Ds-Maker-College/DMC_Tracer_-01/README.md

# DMC Tracer 01 Nano

This is an open-source robot for the DMC Remote Robot contest.
