Ds-Maker-College/DMC_Tracer_-01/Courses/DMC_RoboCon1_Complex_Course.pdf

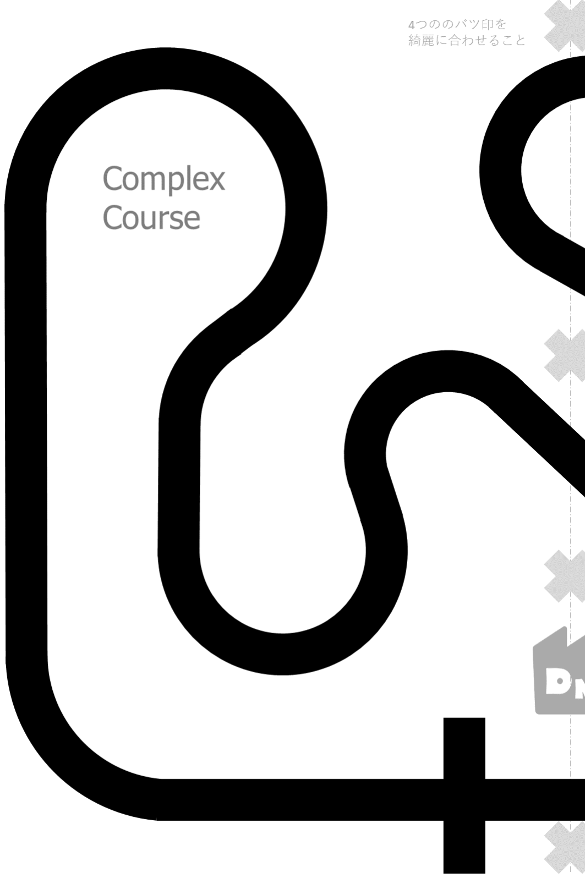
[picture p10: page 1]
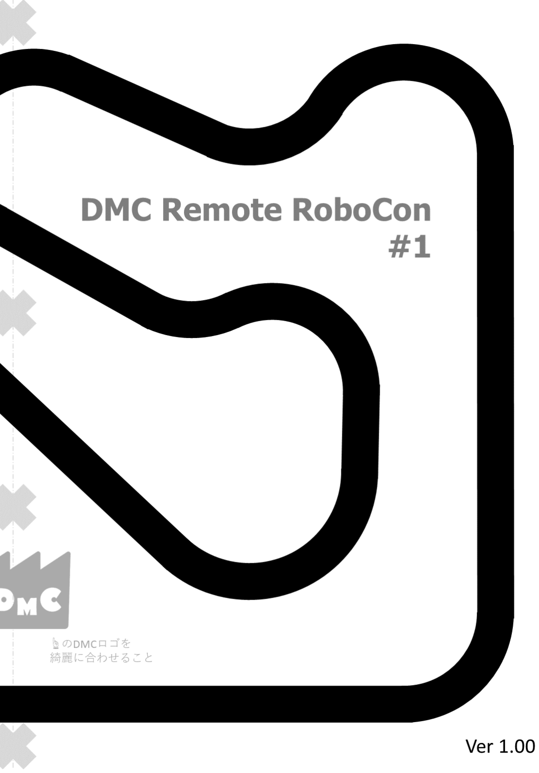
[picture p11: page 2]
