Ds-Maker-College/DMC_Tracer_-01/Courses/DMC_RoboCon1_Simple_Course.pdf

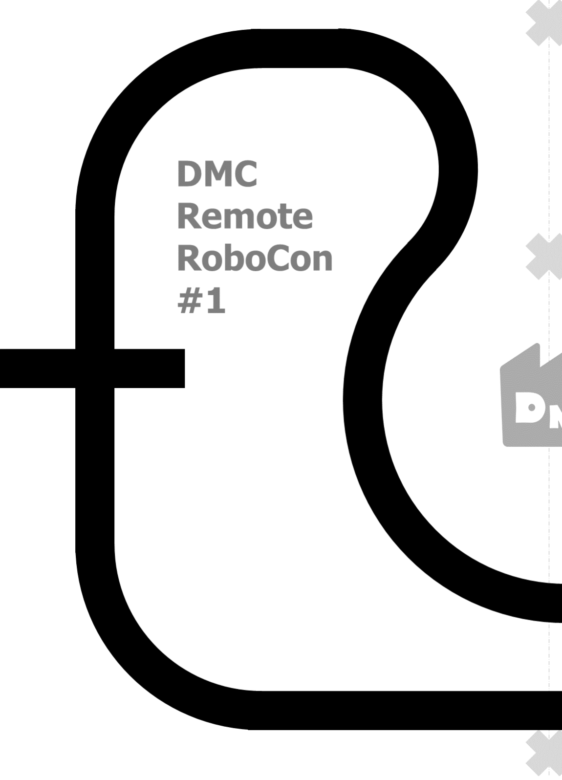
[picture p12: page 1]
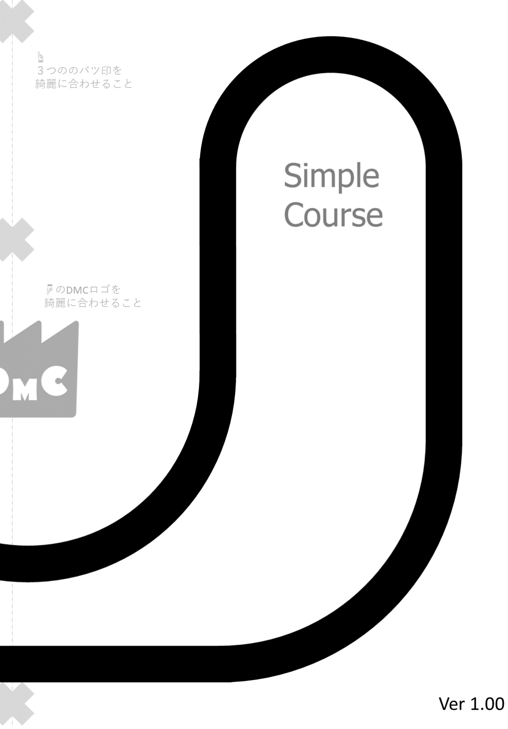
[picture p13: page 2]
