Ds-Maker-College/DMC_Tracer_-01/DMC Tracer Data/V1.1/Parts List.xlsx

部品名 | 製品名（型番) | 数量 | 単価 | 費用 | 調達先 | URL
マイコンボード | Arduino nano互換 | 1 |  |  | アマゾン | https://www.amazon.co.jp/ELEGOO-Arduino-Nano%E3%83%9C%E3%83%BC%E3%83%89-ATmega328P%E3%80%81Arduino-V3-0%E4%BA%92%E6%8F%9B/dp/B072F5NS4X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
I2Cモニタ | OLED 128 × 32 | 1 |  |  | アマゾン | https://www.amazon.co.jp/KKHMF-%E3%82%B7%E3%83%AA%E3%82%A2%E3%83%ABOLED%E6%B6%B2%E6%99%B6%E3%83%87%E3%82%A3%E3%82%B9%E3%83%97%E3%83%AC%E3%82%A4%E3%83%A2%E3%82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
ギヤモーター | FM90 | 2 | 300 | 600 | 秋月 | https://akizukidenshi.com/catalog/g/gM-14801/
ホイール・タイヤ | FS90R-W | 2 | 220 | 440 | 秋月 | http://akizukidenshi.com/catalog/g/gP-13207/
9V電池 |  | 1 | 170 | 170 | 秋月 | https://akizukidenshi.com/catalog/g/gB-03257/
9Vバッテリスナップ |  | 1 | 80 | 80 | 秋月 | https://akizukidenshi.com/catalog/g/gP-07356/
本体基板 | DMC_TracerV1.1 | 1 |  |  | FusionPCB | https://www.fusionpcb.jp/fusion_pcb.html
M2x18ネジ |  | 4 |  |  | 汎用品でOK
M2x8ネジ |  | 6 |  |  | 汎用品でOK
M2x8六角ボルト |  | 6 |  |  | 汎用品でOK
M2ナット |  | 6 |  |  | 汎用品でOK
モーターマウント部品（左右） |  | 2 |  |  | 3Dプリント
リヤスキッド部品 |  | 1 |  |  | 3Dプリント
両面テープ(20cm) |  | 1 |  |  | アマゾン | https://www.amazon.co.jp/OTOKU-%E4%B8%A1%E9%9D%A2%E3%83%86%E3%83%BC%E3%83%97-%E9%AD%94%E6%B3%95%E3%83%86%E3%83%BC%E3%83%97-%E3%81%AE%E3%82%8A%E6%AE%8B%E3%82%8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
