Ds-Maker-College/DMC_Tracer_-01/DMC Tracer Data/V1.1/Parts List(PCB).xlsx

Designator | MPN/Seeed SKU | Qty | Link
CN1,CN2 | 220S-1*15P H=8.5MM Y型 镀金 | 2
J1 | 320120003 | 1
J2,J3 | A2541WR-2P | 2
J4 | 320030017 | 1
R1,R2,R3,R4 | 301010311 | 4
R5,R6 | 301012207 | 2
R7,R8 | 3362P-1-103 | 2
C1,C2 | SVZ1EM101E06E00RAXXX | 2
C3,C4 | 302010138 | 2
L1,L2 | SWPA8040S471MT | 2
D1,D2 | 304060001 | 2
D3 | 304020034 | 1
SW1 | 311030008 | 1
SW2,SW3 | K2-1102DP-K4SW-04 | 2
U1,U2,U3,U4 | ITR9909 | 4
U5 | DRV8835DSSR | 1
