Ds-Maker-College/DMC_Tracer_-01/Mechanical Parts Data/Left_Motor_Mount.SLDPRT

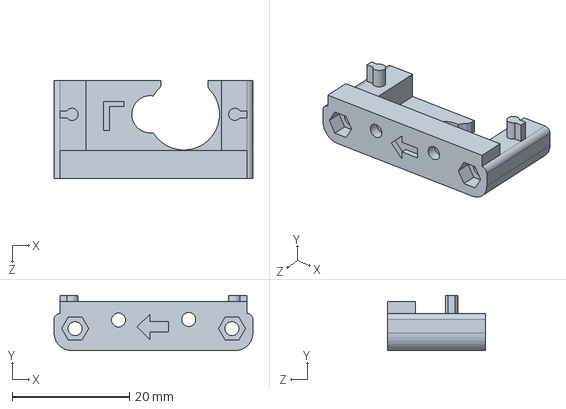
[picture p14: CAD file, 2023-05-11]
Mechanical Parts Data/Left_Motor_Mount.SLDPRT
34.0 x 9.42 x 16.8 mm
