Ds-Maker-College/DMC_Tracer_-01/Mechanical Parts Data/Parts_Set.STL

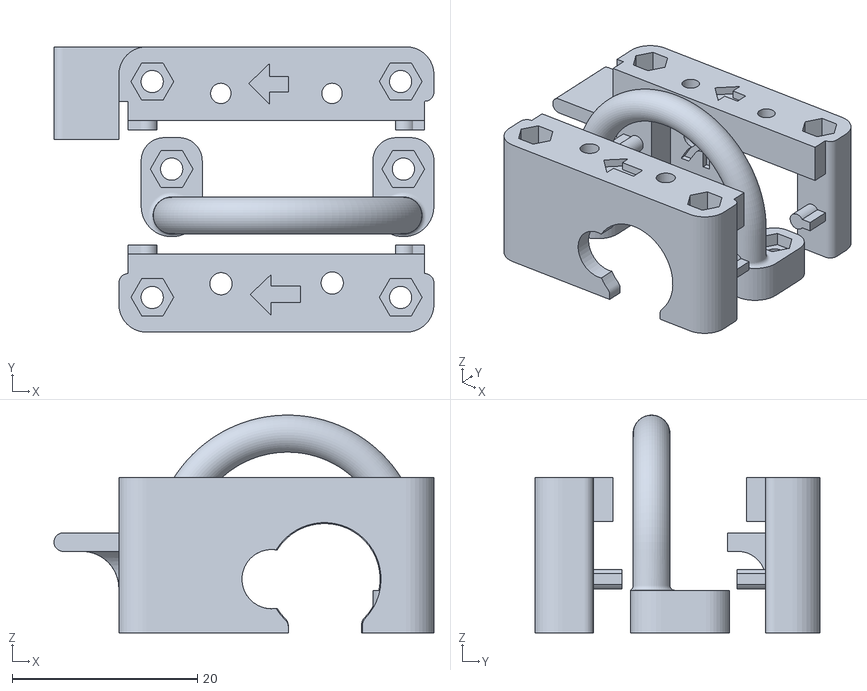
[picture p15: CAD file, 2023-05-11]
Mechanical Parts Data/Parts_Set.STL
41.0 x 30.8 x 23.5
