Ds-Maker-College/DMC_Tracer_-01/Mechanical Parts Data/Right_Motor_Mount.SLDPRT

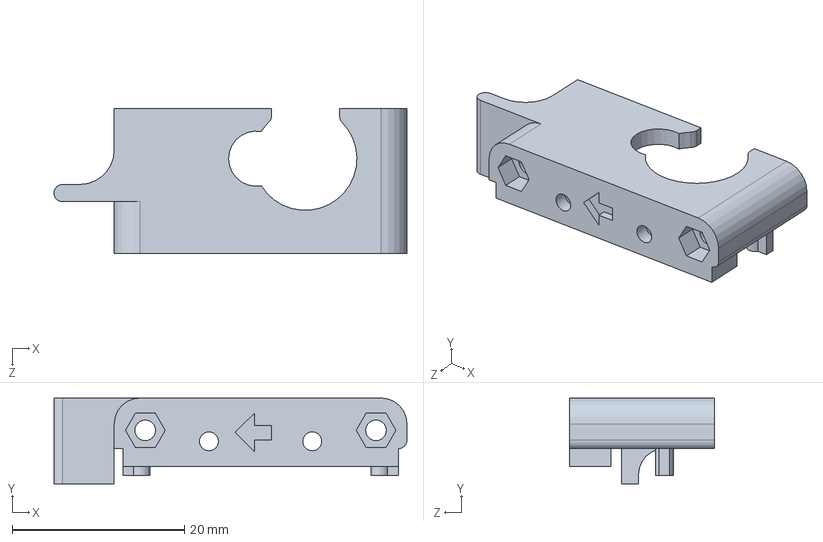
[picture p16: CAD file, 2023-05-11]
Mechanical Parts Data/Right_Motor_Mount.SLDPRT
41.0 x 9.98 x 16.8 mm
