Ds-Maker-College/DMC_Tracer_-01/Mechanical Parts Data/Rear_Skid.SLDPRT

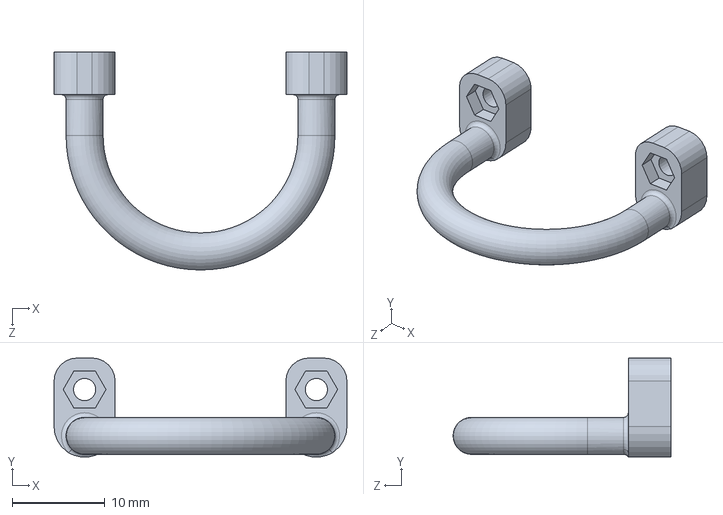
[picture p17: CAD file, 2023-05-11]
Mechanical Parts Data/Rear_Skid.SLDPRT
31.6 x 10.7 x 23.5 mm
