Ds-Maker-College/DMC_Tracer_-01/Courses/Test_Course.pdf

DMC Remote RoboCon

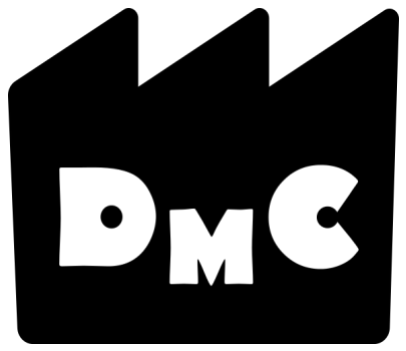
[picture p60: figure]

Test Course
