Ds-Maker-College/DMC_Tracer_-01/DMC Tracer Data/V1.1/DMC_Tracer Schematic.pdf

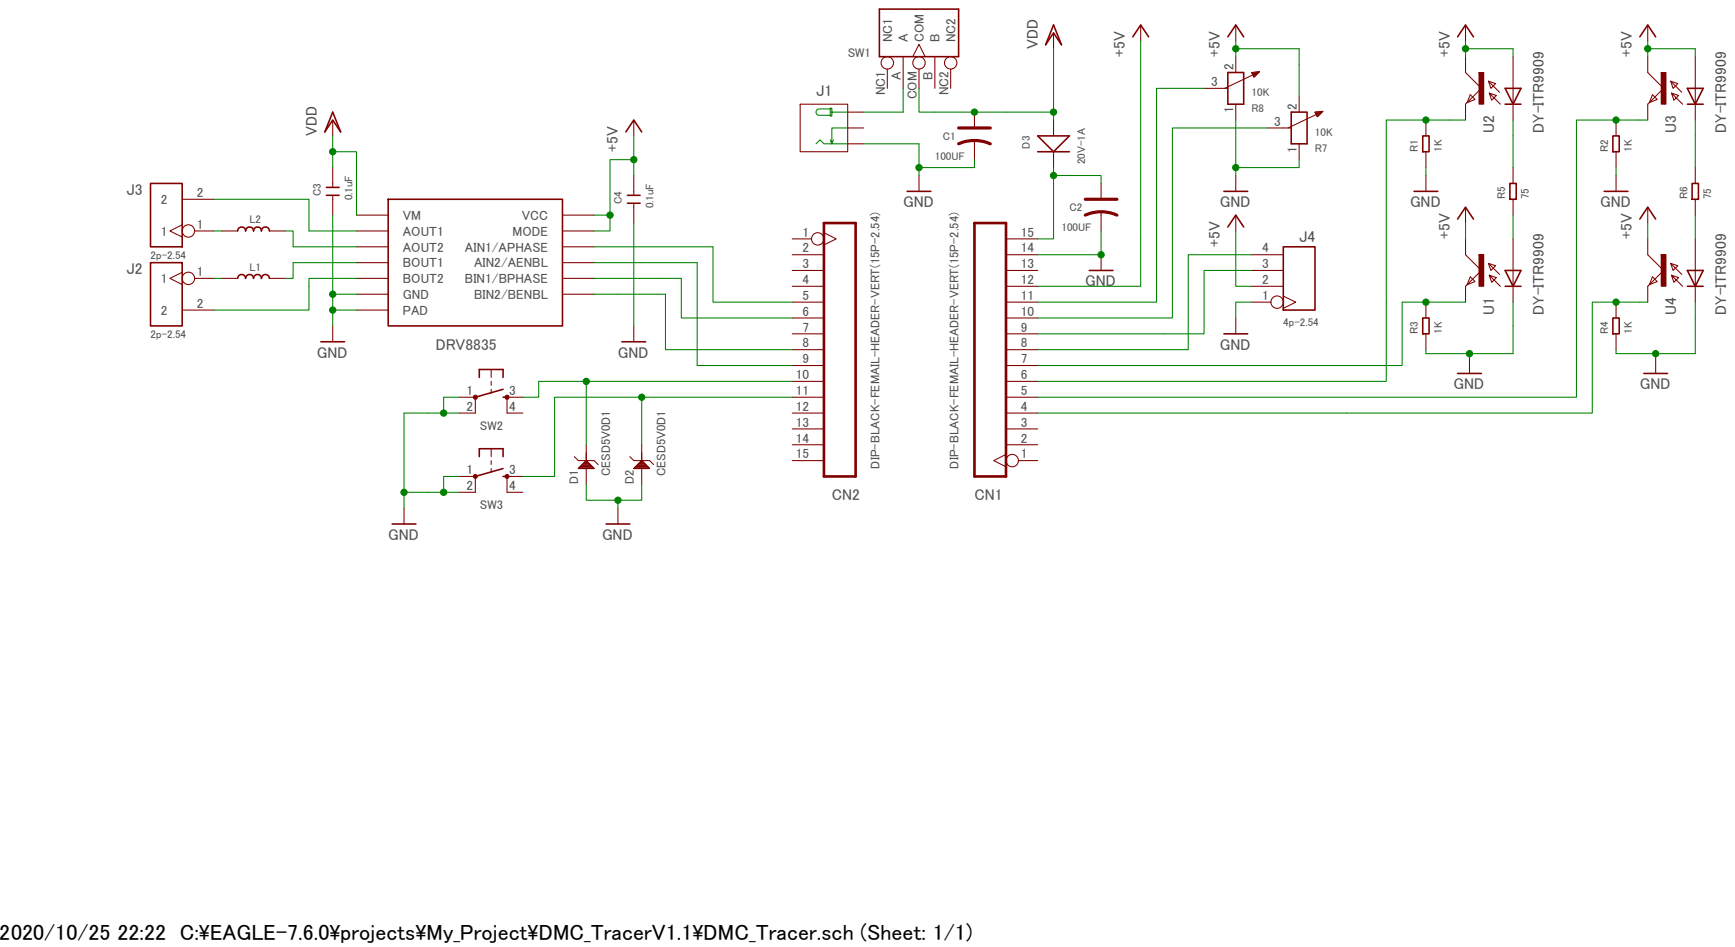
[picture p61: page 1]

DIP-BLACK-FEMAIL-HEADER-VERT(15P-2.54)

2020/10/25 22:22 C:\EAGLE-7.6.0\projects\My_Project\DMC_TracerV1.1\DMC_Tracer.sch (Sheet: 1/1)
