Ds-Maker-College/DMC_Tracer_-01/DMC Tracer Data/V1.1/PP and Mount data V1.1/DMC_TracerV1.1BTM.pdf

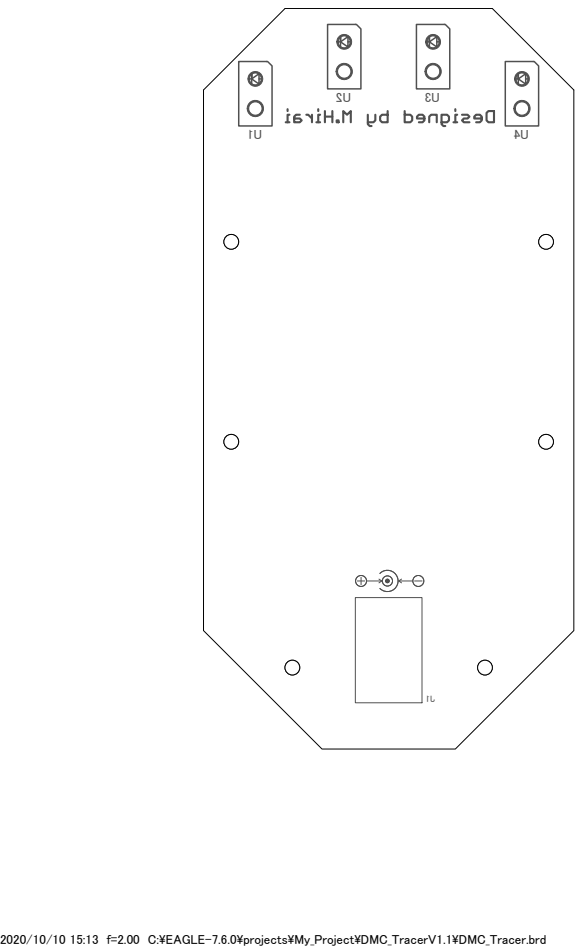
[picture p62: page 1]

2020/10/10 15:13 f=2.00 C:\EAGLE-7.6.0\projects\My_Project\DMC_TracerV1.1\DMC_Tracer.brd
