Ds-Maker-College/DMC_Tracer_-01/DMC Tracer Data/V1.1/PP and Mount data V1.1/DMC_TracerV1.1TOP.pdf

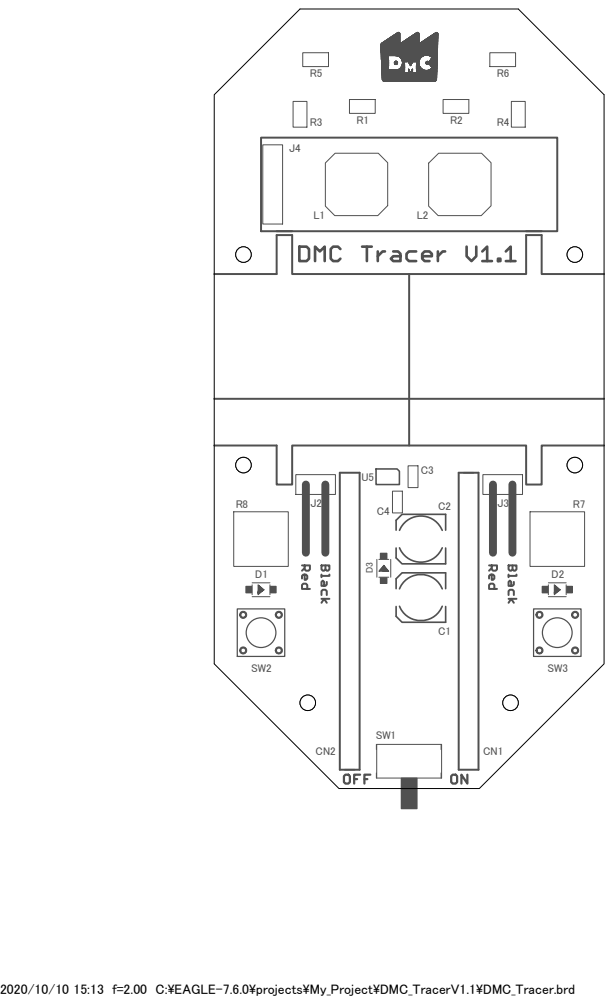
[picture p63: page 1]
