Ds-Maker-College/DMC_Tracer_-01/DMC Tracer Data/V1.1/DMC_TracerV1.1(Eagle data)/DMC_Tracer.brd

## EAGLE design DMC Tracer Data/V1.1/DMC_TracerV1.1(Eagle data)/DMC_Tracer.brd (2023-05-11)

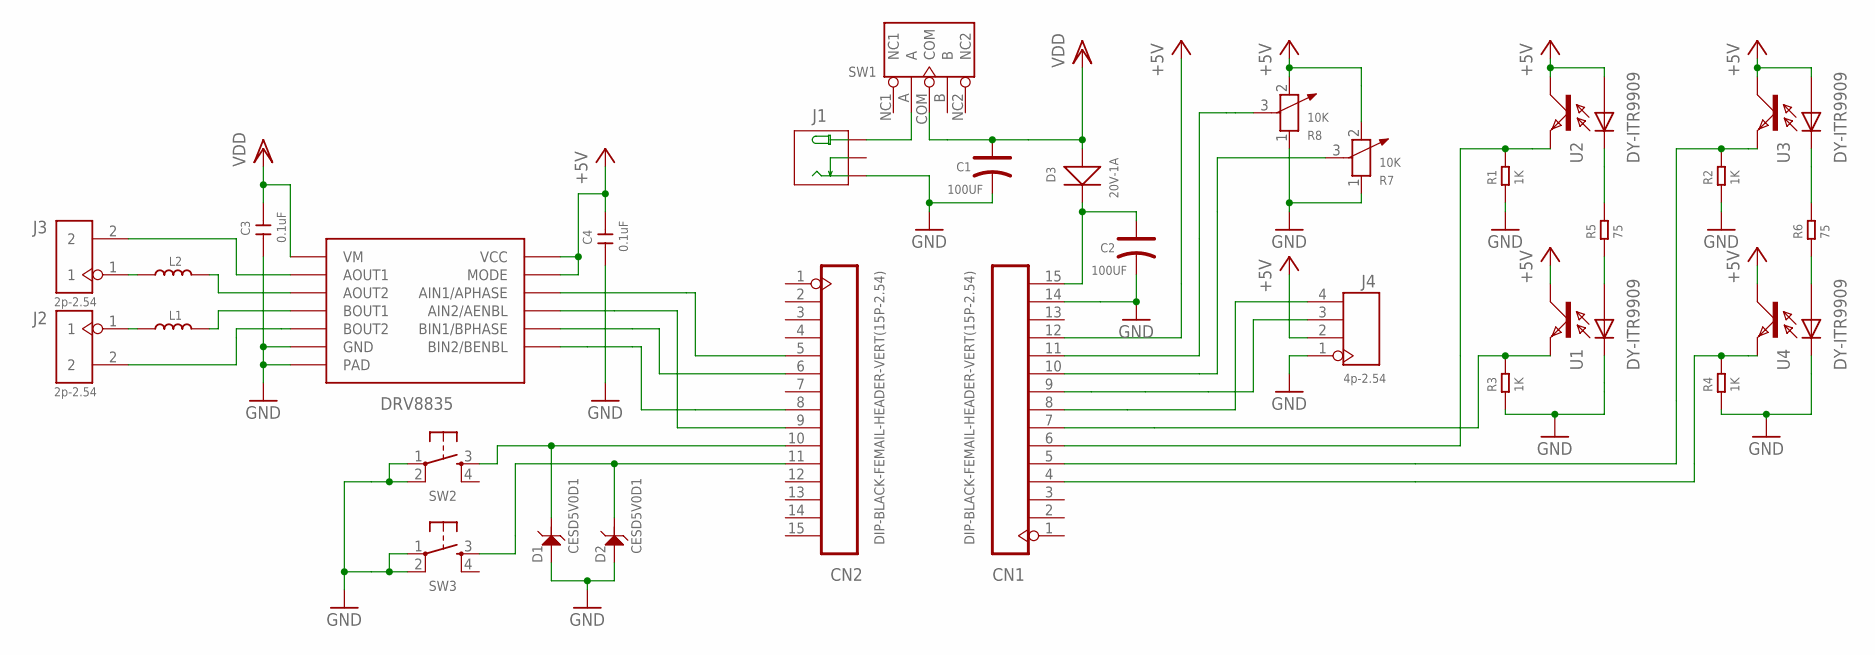
[picture p64: schematic DMC_Tracer.sch]

Parts:
C1, C2: 100UF; ELECTRO-SMD-C-6MM
C3, C4: 0.1uF; C0603
CN1, CN2: DIP-BLACK-FEMAIL-HEADER-VERT(15P-2.54); H15-2.54
D1, D2: CESD5V0D1; SOD-123
D3: 20V-1A; SOD-123
J1: DC-005; 3P-L14.2*W11.0*H9.0MM
J2, J3: 2p-2.54; H2-2.54
J4: 4p-2.54; H4-2.54
L1, L2: SMD-INDUCTOR(2P-8X8MM); L8040
R1, R2, R3, R4: 1K; R0805
R5, R6: 75; R0805
R7, R8: 10K; ADJR3-7.0X7.0X5.0MM
SW1: DIP-TOGGLE-SWITCH-ON-ON(3+2P-8.8X4.6MM)-90D; SW5-2.0-8.8X4.4X4.7MM-90D
SW2, SW3: T-SWITCH-10-SEEED; B3F-10XX-SEEED
U1, U2, U3, U4: DY-ITR9909
U$1: DRV8835; WSON12

Connections:
+5V: C4.1, CN1.12, J4.2, R7.2, R8.2, U1.C, U2.A, U2.C, U3.A, U3.C, U4.C, U$1.P$11 (MODE), U$1.P$12 (VCC)
AOUT1: L2.2, U$1.P$3 (AOUT2)
AOUT2: J3.2, U$1.P$2 (AOUT1)
BOUT1: J2.2, U$1.P$5 (BOUT2)
BOUT2: L1.2, U$1.P$4 (BOUT1)
GND: C1.-, C2.-, C3.2, C4.2, CN1.14, D1.+ (1), D2.+ (1), J1.-1 (-), J4.1, R1.1, R2.1, R3.1, R4.1, R7.1, R8.1, SW2.1, SW2.2 (P1), SW3.1, SW3.2 (P1), U1.K, U4.K, U$1.P$6 (GND), U$1.P$13 (PAD), U$1.P$14 (GND)
unnamed: CN1.8, J4.4
unnamed: CN1.9, J4.3
unnamed: CN2.10, D1.- (2), SW2.3 (S)
unnamed: CN2.11, D2.- (2), SW3.3 (S)
unnamed: CN1.10, R7.3
unnamed: CN1.6, R1.2, U2.E
unnamed: CN1.5, R2.2, U3.E
unnamed: CN1.4, R4.2, U4.E
unnamed: R5.2, U2.K
unnamed: J1.+, SW1.A
unnamed: CN2.5, U$1.P$10 (AIN1/APHASE)
unnamed: R6.2, U3.K
unnamed: J3.1, L2.1
unnamed: R6.1, U4.A
unnamed: R5.1, U1.A
unnamed: CN2.6, U$1.P$8 (BIN1/BPHASE)
unnamed: CN2.9, U$1.P$9 (AIN2/AENBL)
unnamed: CN2.8, U$1.P$7 (BIN2/BENBL)
unnamed: J2.1, L1.1
unnamed: C2.+, CN1.15, D3.-
unnamed: CN1.11, R8.3
unnamed: CN1.7, R3.2, U1.E
VDD: C1.+, C3.1, D3.+, SW1.COM, U$1.P$1 (VM)

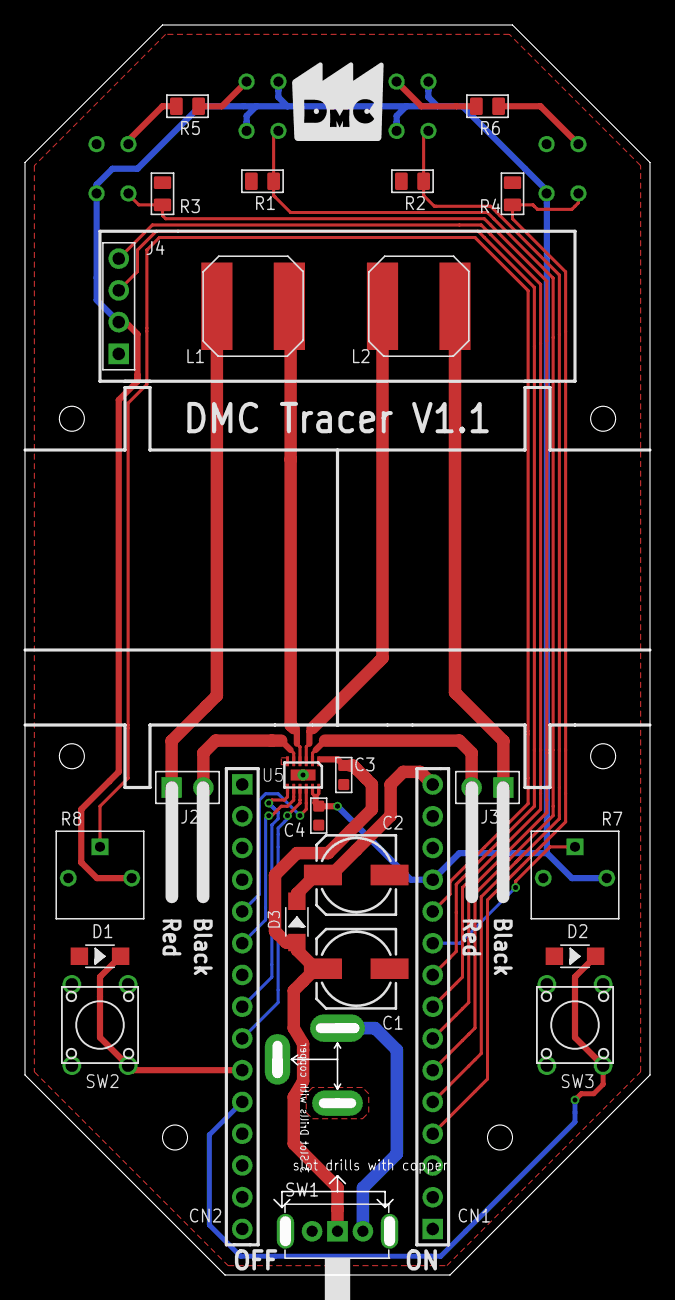
[picture p65: board DMC_Tracer.brd from above]

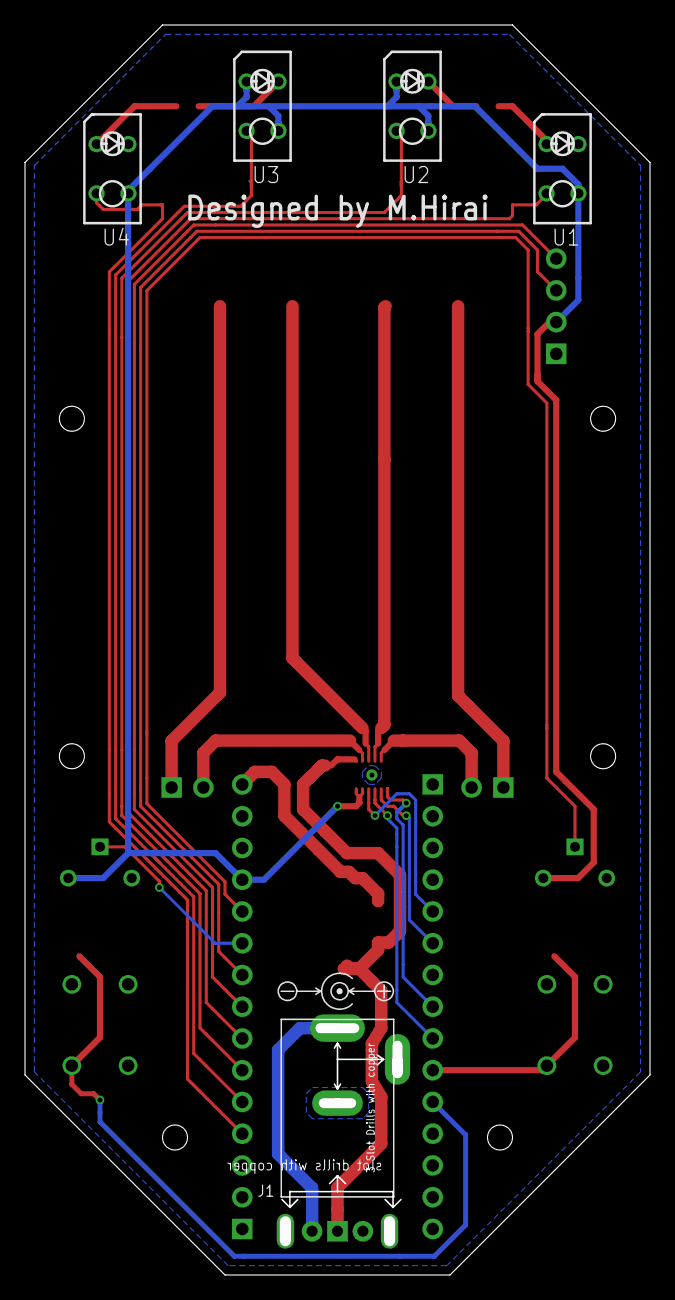
[picture p66: board DMC_Tracer.brd from below]

Board: 2 copper layers, 50.0 x 100.0 mm, 31 parts (5 on the bottom side), 29 nets.
