Ds-Maker-College/DMC_Tracer_-01/Sample Code/Educational Set/06_sample_control/06_sample_control.ino

/////////////////////////////////////////////////////
//    Sample soft for DMC_tracer sample control 
// 
//    Copyright(C) 2021 <DMC>
//    Copyright(C) 2021 M.Hirai, Y.Okada
//    All rights reserved.
// 
//    License: Apache License, Version 2.0
//    https://www.apache.org/licenses/LICENSE-2.0
// 
/////////////////////////////////////////////////////

////////ハードウェアパラメータ/////////
//OLED 関係 基本的に触らない
#include<Wire.h>
#include <Adafruit_SSD1306.h>
#define SCREEN_WIDTH 128 // OLED display width, in pixels
#define SCREEN_HEIGHT 32 // OLED display height, in pixels
// Declaration for an SSD1306 display connected to I2C (SDA, SCL pins)
#define OLED_RESET     4 // Reset pin # (or -1 if sharing Arduino reset pin)
Adafruit_SSD1306 display(SCREEN_WIDTH, SCREEN_HEIGHT, &Wire, OLED_RESET);

// ピン設定
//LED
#define LED       13

//プッシュSW
#define SW_L      7 //スイッチ左
#define SW_R      8 //スイッチ右

//ラインセンサAD
#define LS_L2     3 //外側左センサAD (黒　0->1023　白)
#define LS_L1     2 //内側左センサAD (黒　0->1023　白)
#define LS_R1     1 //内側右センサAD (黒　0->1023　白)
#define LS_R2     0 //外側右センサAD (黒　0->1023　白)

//可変抵抗
#define VR_L      7 //左可変抵抗AD(0->1023)
#define VR_R      6 //右可変抵抗AD(0->1023)

#define MT_PWM_L  5 //左モータPWM (停止 0 -> 255 早)
#define MT_DIR_L  3 //左モータ回転方向 (バック 0 -> 1　前進)
#define MT_PWM_R  6 //右モータPWM (停止 0 -> 255 早)
#define MT_DIR_R  2 //右モータ回転方向 (前進 0 -> 1　バック)

////////ソフトウェアパラメータ/////////

// 定数設定--------------------
#define SW_OFF  HIGH
#define SW_ON   LOW
#define MT_FORWARD_L  HIGH
#define MT_REVERSE_L  LOW
#define MT_FORWARD_R  LOW
#define MT_REVERSE_R  HIGH
//----------------------------

//パラメータ設定-------------------------------------------
#define THREAD_LINE 200 //IRセンサがゴールラインを認識する閾値
#define LAP_NUM 2       //周回数(レースモード時)

#define MOTOR_MAX 255
#define MOTOR_MIN 0

#define LS_L1_MAX 520
#define LS_L1_MIN 60
#define LS_R1_MAX 570
#define LS_R1_MIN 70

#define LS_L2_MAX 390
#define LS_L2_MIN 50
#define LS_R2_MAX 390
#define LS_R2_MIN 50
//-------------------------------------------------------

//変数宣言---------------------
long  line_sensor_l1;
long  line_sensor_r1;
long  line_sensor_l2;
long  line_sensor_r2;

long  vr_ad_l;
long  vr_ad_r;

long  vel_set_l;
long  vel_set_r;

unsigned long start_time;
unsigned long total_time;
unsigned long lap_time[LAP_NUM+1];
unsigned long boot_time;
byte n_lap = 0;

//----------------------------

//初期設定関数
void setup() {
  // put your setup code here, to run once:
  //　起動時最初に１回だけ走るプログラム

  //IOポート設定
  pinMode(LED,OUTPUT);
  pinMode(SW_R,INPUT_PULLUP);
  pinMode(SW_L,INPUT_PULLUP);

  //モータの回転方向を設定
  digitalWrite(MT_DIR_L,MT_FORWARD_L);  //前進
  digitalWrite(MT_DIR_R,MT_FORWARD_R);  //前進
  
  //シリアル通信を開始
  Serial.begin(9600);

  // Wire(Arduino-I2C)の初期化
  Wire.begin();
  
  //OLED初期化　Address 0x3C for 128x32
  if (!display.begin(SSD1306_SWITCHCAPVCC, 0x3C)){ 
    Serial.println(F("SSD1306 allocation failed"));
    while(1); // Don't proceed, loop forever
  }

  //機種名をOLEDに表示----------------
  display.clearDisplay();
  display.setTextSize(2); 
  display.setTextColor(SSD1306_WHITE);
  display.setCursor(4,7);
  display.print(F("DMC TRACER"));
  display.display();
  delay(1000);
 //----------------------------------

  //走行前にセンサの確認
  while(1){

    //右スイッチが推されたらループを出る
    if( digitalRead(SW_R) == SW_ON ){break;}
    
    //ラインセンサを読み込む
    line_sensor_l1 = analogRead(LS_L1);
    line_sensor_r1 = analogRead(LS_R1);
    line_sensor_l2 = analogRead(LS_L2);
    line_sensor_r2 = analogRead(LS_R2);

    //ボリュームの読み込み
    vr_ad_l  = analogRead(VR_L);
    vr_ad_r  = analogRead(VR_R);

    //ボリュームのAD値(10bit)をPWM値(8bit)に変換
    vel_set_l = vr_ad_l * 255 / 1023;
    vel_set_r = vr_ad_r * 255 / 1023;

    //シリアル通信でセンサの値を確認
    Serial.print(line_sensor_l2);   //ラインセンサ左の外側の値を表示
    Serial.print("\t");
    Serial.print(line_sensor_l1);   //ラインセンサ左の内側の値を表示
    Serial.print("\t");
    Serial.print(line_sensor_r1);   //ラインセンサ右の内側の値を表示
    Serial.print("\t");
    Serial.print(line_sensor_r2);   //ラインセンサ右の外側の値を表示
    Serial.print("\t");

    Serial.print(vr_ad_l);          //左ボリュームの値を表示
    Serial.print("\t");
    Serial.print(vr_ad_r);          //右ボリュームの値を表示
    Serial.print("\t");

    Serial.print(vel_set_l);        //左輪速度設定の値を表示
    Serial.print("\t");
    Serial.print(vel_set_r);        //右輪速度設定の値を表示
    Serial.print("\t");
    Serial.println("");   // 改行

    //OLEDに各パラメータ値出力(デバッグ用)
    display.clearDisplay();
    display.setTextSize(1); // Draw 2X-scale text
    display.setTextColor(SSD1306_WHITE);

    //一段目の表示　ソフトのバージョン
    display.setCursor(0, 0);
    display.print(F("Ver:Sample Control"));
    
    //二段目の表示　ボリュームの速度設定
    display.setCursor(0, 11);
    display.print(F("VsetL:"));
    display.print(vel_set_l);
    display.print(", ");
    display.print(F("VsetR:"));
    display.print(vel_set_r);
    display.print("\n");

    //三段目の表示　ラインセンサの値
    display.setCursor(0,22);
    display.println(F("Sens"));
    display.setCursor(35,22);
    display.println(line_sensor_l2, DEC);
    display.setCursor(60,22);
    display.println(line_sensor_l1, DEC);
    display.setCursor(85,22);
    display.println(line_sensor_r1, DEC);
    display.setCursor(110,22);
    display.println(line_sensor_r2, DEC);
    display.display();
    delay(10);
  }
}

//メインループ
void loop() {

  // put your main code here, to run repeatedly:

  long  ls_l1,ls_r1,ls_l2,ls_r2;  //ラインセンサ正規化用変数
  long  line_control;             //ライン制御用差分計算変数

  int   motor_set_L;  //左モーターの速度セット変数
  int   motor_set_R;  //右モーターの速度セット変数
 
  //繰り返し走るプログラム

  //ラインセンサ値を読み込む
  line_sensor_l1 = analogRead(LS_L1);
  line_sensor_r1 = analogRead(LS_R1);
  line_sensor_l2 = analogRead(LS_L2);
  line_sensor_r2 = analogRead(LS_R2);

  //センサ値の正規化処理
  ls_l1 = (line_sensor_l1 - LS_L1_MIN) * 1024 / (LS_L1_MAX - LS_L1_MIN);
  ls_r1 = (line_sensor_r1 - LS_R1_MIN) * 1024 / (LS_R1_MAX - LS_R1_MIN);
  ls_l2 = (line_sensor_l2 - LS_L2_MIN) * 1024 / (LS_L2_MAX - LS_L2_MIN);
  ls_r2 = (line_sensor_r2 - LS_R2_MIN) * 1024 / (LS_R2_MAX - LS_R2_MIN);

  //ラインセンサ値の最小ガード
  if(ls_l1 < 0){ ls_l1 = 0; }
  if(ls_r1 < 0){ ls_r1 = 0; }
  if(ls_l2 < 0){ ls_l2 = 0; }
  if(ls_r2 < 0){ ls_r2 = 0; }

  //ラインセンサ値の最大ガード
  if(ls_l1 >= 1024){ ls_l1 = 1024; }
  if(ls_r1 >= 1024){ ls_r1 = 1024; }
  if(ls_l2 >= 1024){ ls_l2 = 1024; }
  if(ls_r2 >= 1024){ ls_r2 = 1024; }

  line_control = (int)line_sensor_l1 - (int)line_sensor_r1 + 2*((int)line_sensor_l2 - (int)line_sensor_r2);

  motor_set_L = vel_set_l + line_control / 15;
  motor_set_R = vel_set_r - line_control / 15;
  
  //モーター駆動処理
  //左モーター出力
  if(motor_set_L >= 0){
    if(motor_set_L > MOTOR_MAX) {motor_set_L = MOTOR_MAX;}  //モーター制御値上下ガード処理
    if(motor_set_L <= MOTOR_MIN){motor_set_L = MOTOR_MIN;}  //モーター制御値上下ガード処理
    digitalWrite(MT_DIR_L, MT_FORWARD_L);
    analogWrite(MT_PWM_L, motor_set_L);       // 左モーターPWM 
  }
  else if(motor_set_L < 0){
    motor_set_L = -motor_set_L;
    if(motor_set_L > MOTOR_MAX) {motor_set_L = MOTOR_MAX;}  //モーター制御値上下ガード処理
    if(motor_set_L <= MOTOR_MIN){motor_set_L = MOTOR_MIN;}  //モーター制御値上下ガード処理
    digitalWrite(MT_DIR_L, MT_REVERSE_L);
    analogWrite(MT_PWM_L, motor_set_L);       // 左モーターPWM 
  }
    
  //右モーターPWM出力
  if(motor_set_R >= 0){
    if(motor_set_R > MOTOR_MAX) {motor_set_R = MOTOR_MAX;}   //モーター制御値上下ガード処理
    if(motor_set_R <= MOTOR_MIN){motor_set_R = MOTOR_MIN;}  //モーター制御値上下ガード処理
    digitalWrite(MT_DIR_R, MT_FORWARD_R);
    analogWrite(MT_PWM_R, motor_set_R);       // 左モーターPWM 
  }
  else if(motor_set_R < 0){
    motor_set_R = -motor_set_R;
    if(motor_set_R > MOTOR_MAX) {motor_set_R = MOTOR_MAX;}   //モーター制御値上下ガード処理
    if(motor_set_R <= MOTOR_MIN){motor_set_R = MOTOR_MIN;}  //モーター制御値上下ガード処理
    digitalWrite(MT_DIR_R, MT_REVERSE_R);
    analogWrite(MT_PWM_R, motor_set_R);       // 左モーターPWM 
  }

  //デバック用コード
/*  Serial.print(ls_l2);
  Serial.print("\t");
  Serial.print(ls_l1);
  Serial.print("\t");
  Serial.print(ls_r1);
  Serial.print("\t");
  Serial.print(ls_r2);
  Serial.print("\t");
  Serial.println("");      // 改行
*/

  //駆動制御変数確認デバックコード
/*  Serial.print(line_control);
  Serial.print("\t");
  Serial.print(motor_set_L);  //左モータ速度変数の値を表示
  Serial.print("\t");
  Serial.print(motor_set_R);  //右モータ速度変数の値を表示
  Serial.print("\t");
  Serial.println("");   // 改行
*/

  //↓↓↓↓↓↓↓↓↓↓↓↓↓↓↓ここから編集NG↓↓↓↓↓↓↓↓↓↓↓↓↓↓↓↓↓↓↓↓↓↓↓
  //走行時間や周回計測をしています
  boot_time = millis();
  goal_lap_check();//編集禁止
  time_check();//編集禁止
  //周回数が所定以上で停止
  if (n_lap > LAP_NUM){
    analogWrite(MT_PWM_R,0);
    analogWrite(MT_PWM_L,0);
    disp_lap_time();
    while(1)
    {
      //ゴール時無限ループ
    }
  }
  //↑↑↑↑↑↑↑↑↑↑↑↑↑↑↑↑ここまで編集NG↑↑↑↑↑↑↑↑↑↑↑↑↑↑↑↑↑↑↑↑↑↑
 
}

//↓↓↓↓↓↓↓↓↓↓↓↓↓↓↓↓↓↓↓↓↓↓↓↓↓↓↓↓↓↓↓↓↓↓↓↓↓↓↓↓↓↓↓↓↓↓
//↓↓↓↓↓↓↓↓↓↓↓↓↓↓↓以下関数編集禁止↓↓↓↓↓↓↓↓↓↓↓↓↓↓↓↓↓↓↓↓↓↓↓
//↓↓↓↓↓↓↓↓↓↓↓↓↓↓↓↓↓↓↓↓↓↓↓↓↓↓↓↓↓↓↓↓↓↓↓↓↓↓↓↓↓↓↓↓↓↓

//走行時間処理(編集禁止)
void time_check(void)
{
  static unsigned long boot_time_prev = 0;
  //レース中、タイマー計算
  if ((n_lap > 0) && (n_lap <= LAP_NUM)){
    total_time = boot_time - start_time;
  }
  //10msに1回ディスプレイ更新
  if(boot_time - boot_time_prev < 10)
  {
  }else{
    boot_time_prev = boot_time;
    disp_lap_time();
  }
}

//ゴール判定とラップカウンタ(編集禁止)
void goal_lap_check(void){

  bool flg_sgline;
  bool static flg_sgline_prev = 0; 
  byte static disp_count;
  
  //ゴールラインのチェック処理----------------------------------------
  bool t_ls11 = (line_sensor_l1 < THREAD_LINE);
  bool t_lsr1 = (line_sensor_r1 < THREAD_LINE);
  bool t_lsl2 = (line_sensor_l2 < THREAD_LINE);
  bool t_lsr2 = (line_sensor_r2 < THREAD_LINE);

  flg_sgline = 0;
  //すべてのセンサでラインを検出したとき、ゴールラインの検出とする。
  if ((t_ls11 == 1) && (t_lsr1 == 1) && (t_lsl2 == 1) && (t_lsr2 == 1)) 
  {
    flg_sgline = 1;
  } 
  bool t_line = LOW;
  //ゴールラインを検出　かつ　前回ゴールラインを検出していないとき
  //ゴールライン検出フラグをたて、ラップ数をインクリメント、ラップタイムを記録する。
  if ((flg_sgline == 1) && (flg_sgline_prev == 0)) {
    t_line = HIGH;
    if (n_lap == 0) {
      start_time = boot_time;
    } else if (n_lap <= LAP_NUM){
      if (n_lap > 1) {
        lap_time[n_lap] = boot_time - lap_time[n_lap - 1];
      } else {
        lap_time[n_lap] = boot_time - start_time;
      }
    }
    n_lap = n_lap + 1;
  }

  //前回ゴールライン検出フラグを更新
  flg_sgline_prev = flg_sgline;
}

//走行時間表示処理(編集禁止)
void disp_lap_time(void)
{
  display.clearDisplay();

  display.setTextSize(2); 
  display.setCursor(0, 0);
  display.print(F("T:"));

  float tt = ((float)total_time /1000.0);//時間の単位を変換[ms->s]

  display.print(tt,2);

  display.setTextSize(2); 
  display.setCursor(0, 16);
  display.print(F("L:"));

  display.setCursor(40, 16);
  display.print(n_lap);
  display.display();
}
